PedroBMedeiros/PolySaber/PolySaber/PolySaber.kicad_pcb

## KiCad design PolySaber/PolySaber.kicad_pcb (2026-06-04)

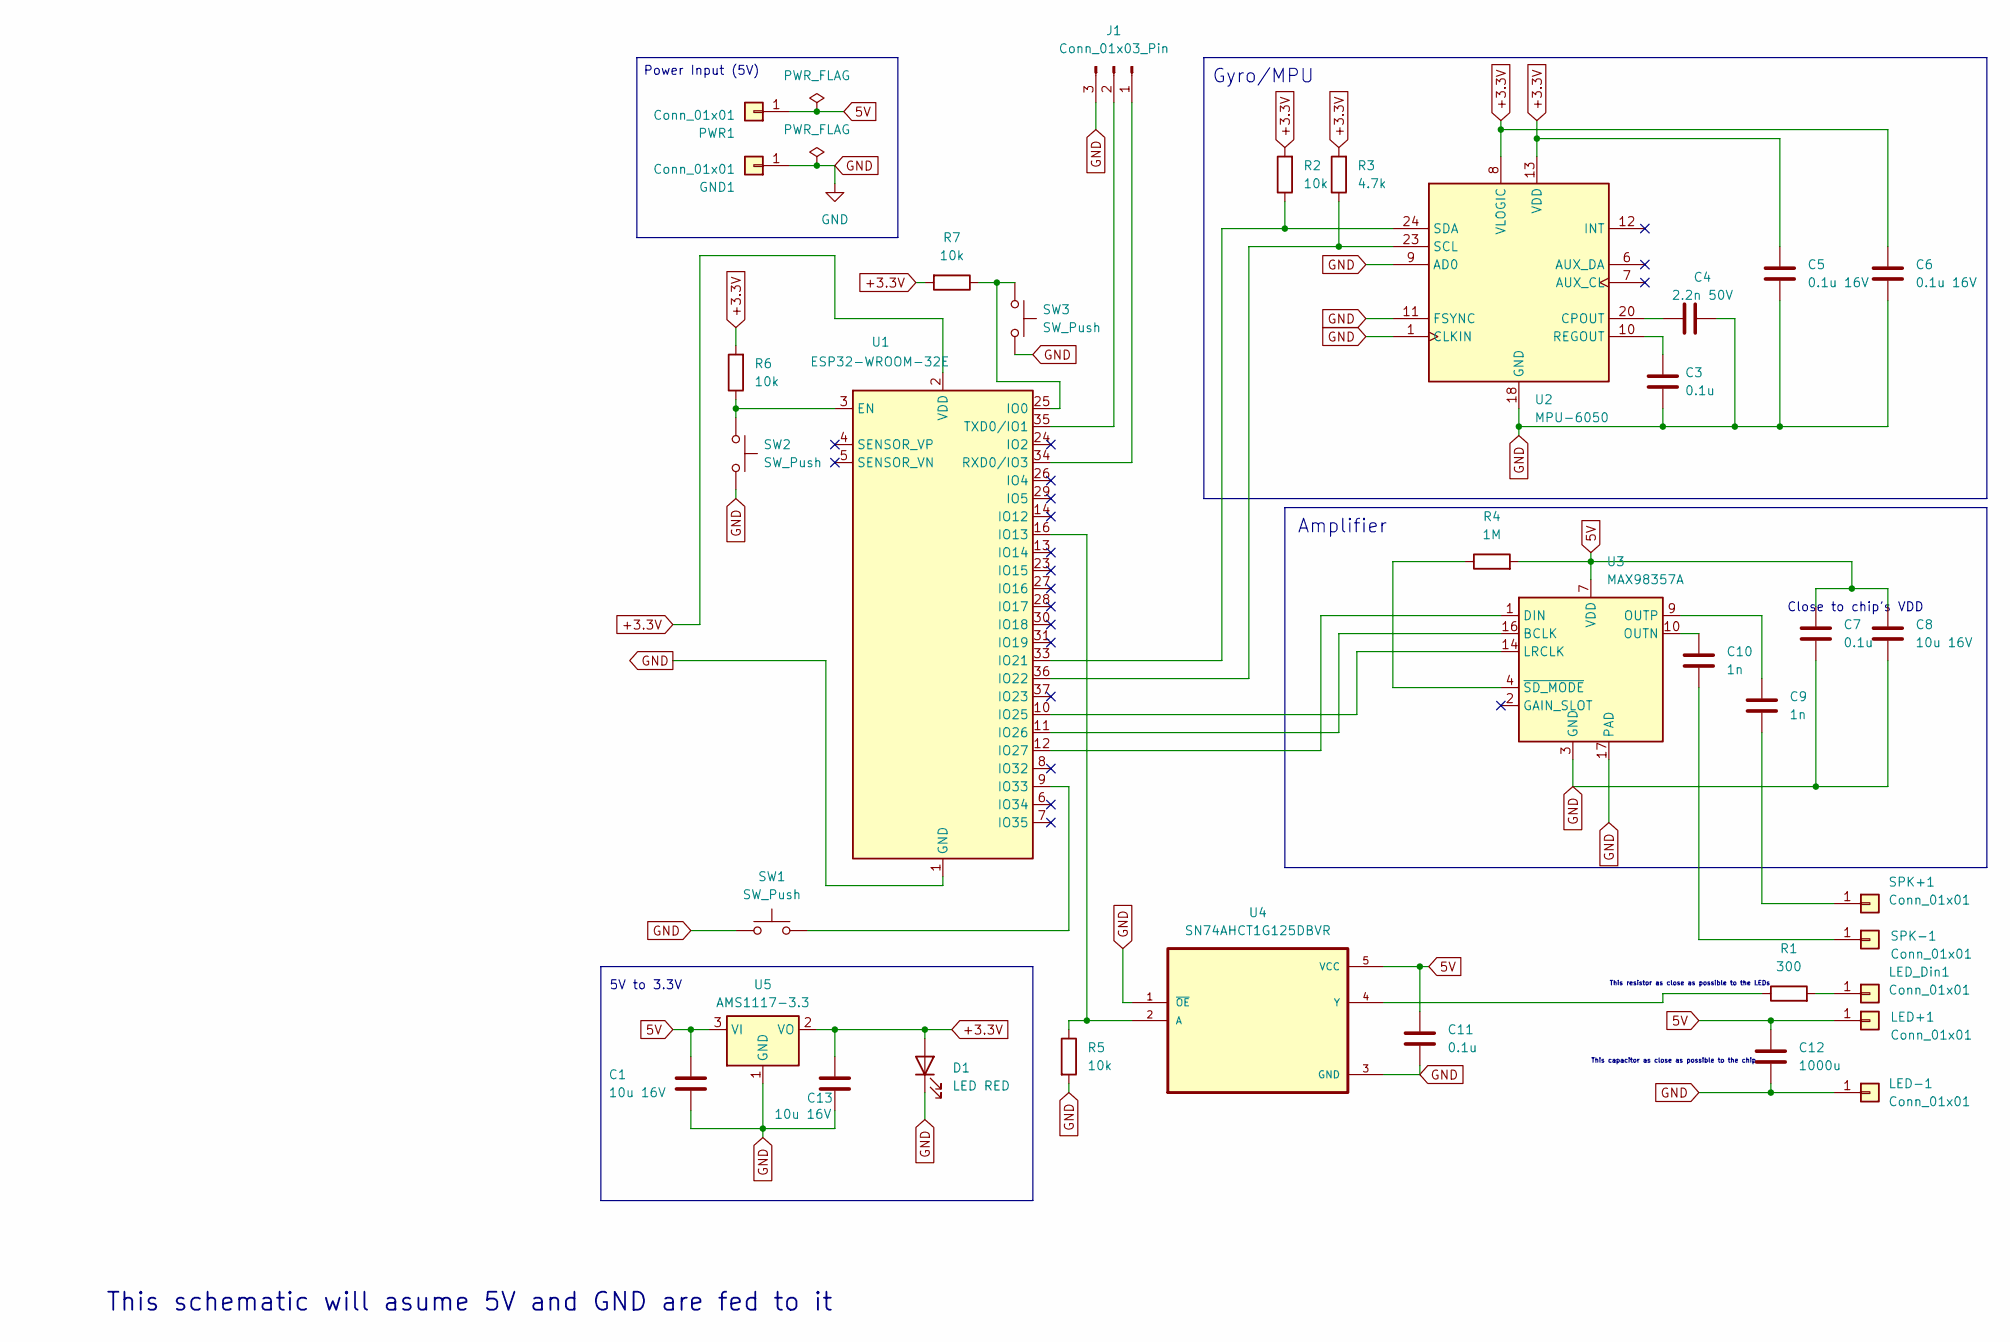
[picture p1: schematic PolySaber.kicad_sch]

Parts:
C1, C8, C13: 10u 16V; C_0603_1608Metric_Pad1.08x0.95mm_HandSolder; LCSC C19702
C3: 0.1u; C_0201_0603Metric_Pad0.64x0.40mm_HandSolder; LCSC C14663
C4: 2.2n 50V; C_0603_1608Metric_Pad1.08x0.95mm_HandSolder; LCSC C1604
C5, C6: 0.1u 16V; C_0603_1608Metric_Pad1.08x0.95mm_HandSolder; LCSC C14663
C7, C11: 0.1u; C_0603_1608Metric_Pad1.08x0.95mm_HandSolder; LCSC C14663
C9, C10: 1n; C_0201_0603Metric_Pad0.64x0.40mm_HandSolder; LCSC C1588
C12: 1000u; CP_Radial_D10.0mm_P5.00mm; LCSC C439782
D1: LED RED; LED_0603_1608Metric_Pad1.05x0.95mm_HandSolder; LCSC C2286
GND1: Conn_01x01; TestPoint_Pad_4.0x4.0mm
J1: Conn_01x03_Pin; PinHeader_1x03_P2.54mm_Vertical; LCSC C49257
LED+1: Conn_01x01; TestPoint_Pad_4.0x4.0mm
LED-1: Conn_01x01; TestPoint_Pad_4.0x4.0mm
LED_Din1: Conn_01x01; TestPoint_Pad_4.0x4.0mm
PWR1: Conn_01x01; TestPoint_Pad_4.0x4.0mm
R1: 300; R_0603_1608Metric_Pad0.98x0.95mm_HandSolder; LCSC C23025
R2, R5, R6, R7: 10k; R_0603_1608Metric_Pad0.98x0.95mm_HandSolder; LCSC C25804
R3: 4.7k; R_0603_1608Metric_Pad0.98x0.95mm_HandSolder; LCSC C23162
R4: 1M; R_0603_1608Metric_Pad0.98x0.95mm_HandSolder; LCSC C22935
SPK+1: Conn_01x01; TestPoint_Pad_4.0x4.0mm
SPK-1: Conn_01x01; TestPoint_Pad_4.0x4.0mm
SW1, SW2, SW3: SW_Push; SW_Tactile_SPST_NO_Straight_CK_PTS636Sx25SMTRLFS; LCSC C2689642
U1: ESP32-WROOM-32E; LCSC C701343
U2: MPU-6050; InvenSense_QFN-24_4x4mm_P0.5mm; LCSC C24112
U3: MAX98357A; TQFN-16-1EP_3x3mm_P0.5mm_EP1.23x1.23mm; LCSC C910544
U4: SN74AHCT1G125DBVR; SOT95P280X145-5N; LCSC C7484
U5: AMS1117-3.3; SOT-223-3_TabPin2; LCSC C6186

Connections:
5V: C1.1, C7.1, C8.1, C11.1, C12.1, LED+1.1, PWR1.1, R4.2, U3.7 (VDD), U3.8 (VDD), U4.5 (VCC), U5.3 (VI)
+3.3V: C5.1, C6.1, C13.1, D1.2 (A), R2.2, R3.2, R6.2, R7.2, U1.2 (VDD), U2.8 (VLOGIC), U2.13 (VDD), U5.2 (VO)
GND: C1.2, C3.2, C4.2, C5.2, C6.2, C7.2, C8.2, C11.2, C12.2, C13.2, D1.1 (K), GND1.1, J1.3, LED-1.1, R5.2, SW1.1, SW2.2, SW3.2, U1.1 (GND), U1.15 (GND), U1.38 (GND), U1.39 (GND), U2.1 (CLKIN), U2.9 (AD0), U2.11 (FSYNC), U2.18 (GND), U3.3 (GND), U3.11 (GND), U3.15 (GND), U3.17 (PAD), U4.1 (~OE), U4.3 (GND), U5.1 (GND)
unnamed: J1.1, U1.34 (RXD0/IO3)
unnamed: J1.2, U1.35 (TXD0/IO1)
unnamed: LED_Din1.1, R1.2
unnamed: C9.2, SPK+1.1
unnamed: C10.2, SPK-1.1
unnamed: R6.1, SW2.1, U1.3 (EN)
unnamed: R7.1, SW3.1, U1.25 (IO0)
unnamed: R5.1, U1.16 (IO13), U4.2 (A)
unnamed: R2.1, U1.33 (IO21), U2.24 (SDA)
unnamed: R3.1, U1.36 (IO22), U2.23 (SCL)
unnamed: U1.10 (IO25), U3.14 (LRCLK)
unnamed: U1.11 (IO26), U3.16 (BCLK)
unnamed: U1.12 (IO27), U3.1 (DIN)
unnamed: SW1.2, U1.9 (IO33)
unnamed: C4.1, U2.20 (CPOUT)
unnamed: C3.1, U2.10 (REGOUT)
unnamed: C10.1, U3.10 (OUTN)
unnamed: C9.1, U3.9 (OUTP)
unnamed: R4.1, U3.4 (~SD_MODE)
unnamed: R1.1, U4.4 (Y)

Notes on the sheet:
This schematic will asume 5V and GND are fed to it
Close to chip's VDD
This capacitor as close as possible to the chip
5V to 3.3V
This resistor as close as possible to the LEDs
Gyro/MPU
Amplifier
Power Input (5V)

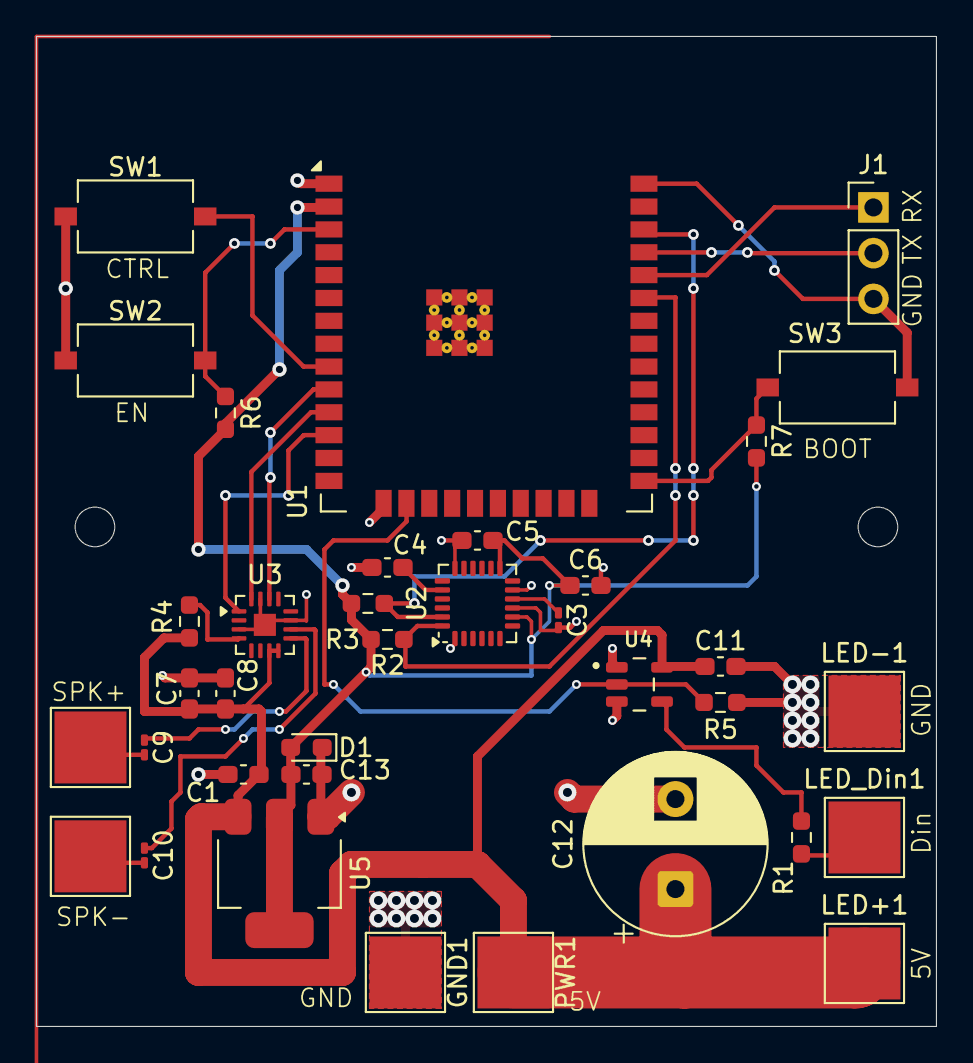
[picture p2: board PolySaber.kicad_pcb from above]

Board: 2 copper layers, 50.0 x 55.0 mm, 36 parts (0 on the bottom side), 23 nets.
