PedroBMedeiros/PolySaber/PolySaberFinalKicad/Zibs_Saber_v2.kicad_pcb

## KiCad design PolySaberFinalKicad/Zibs_Saber_v2.kicad_pcb (2026-06-04)

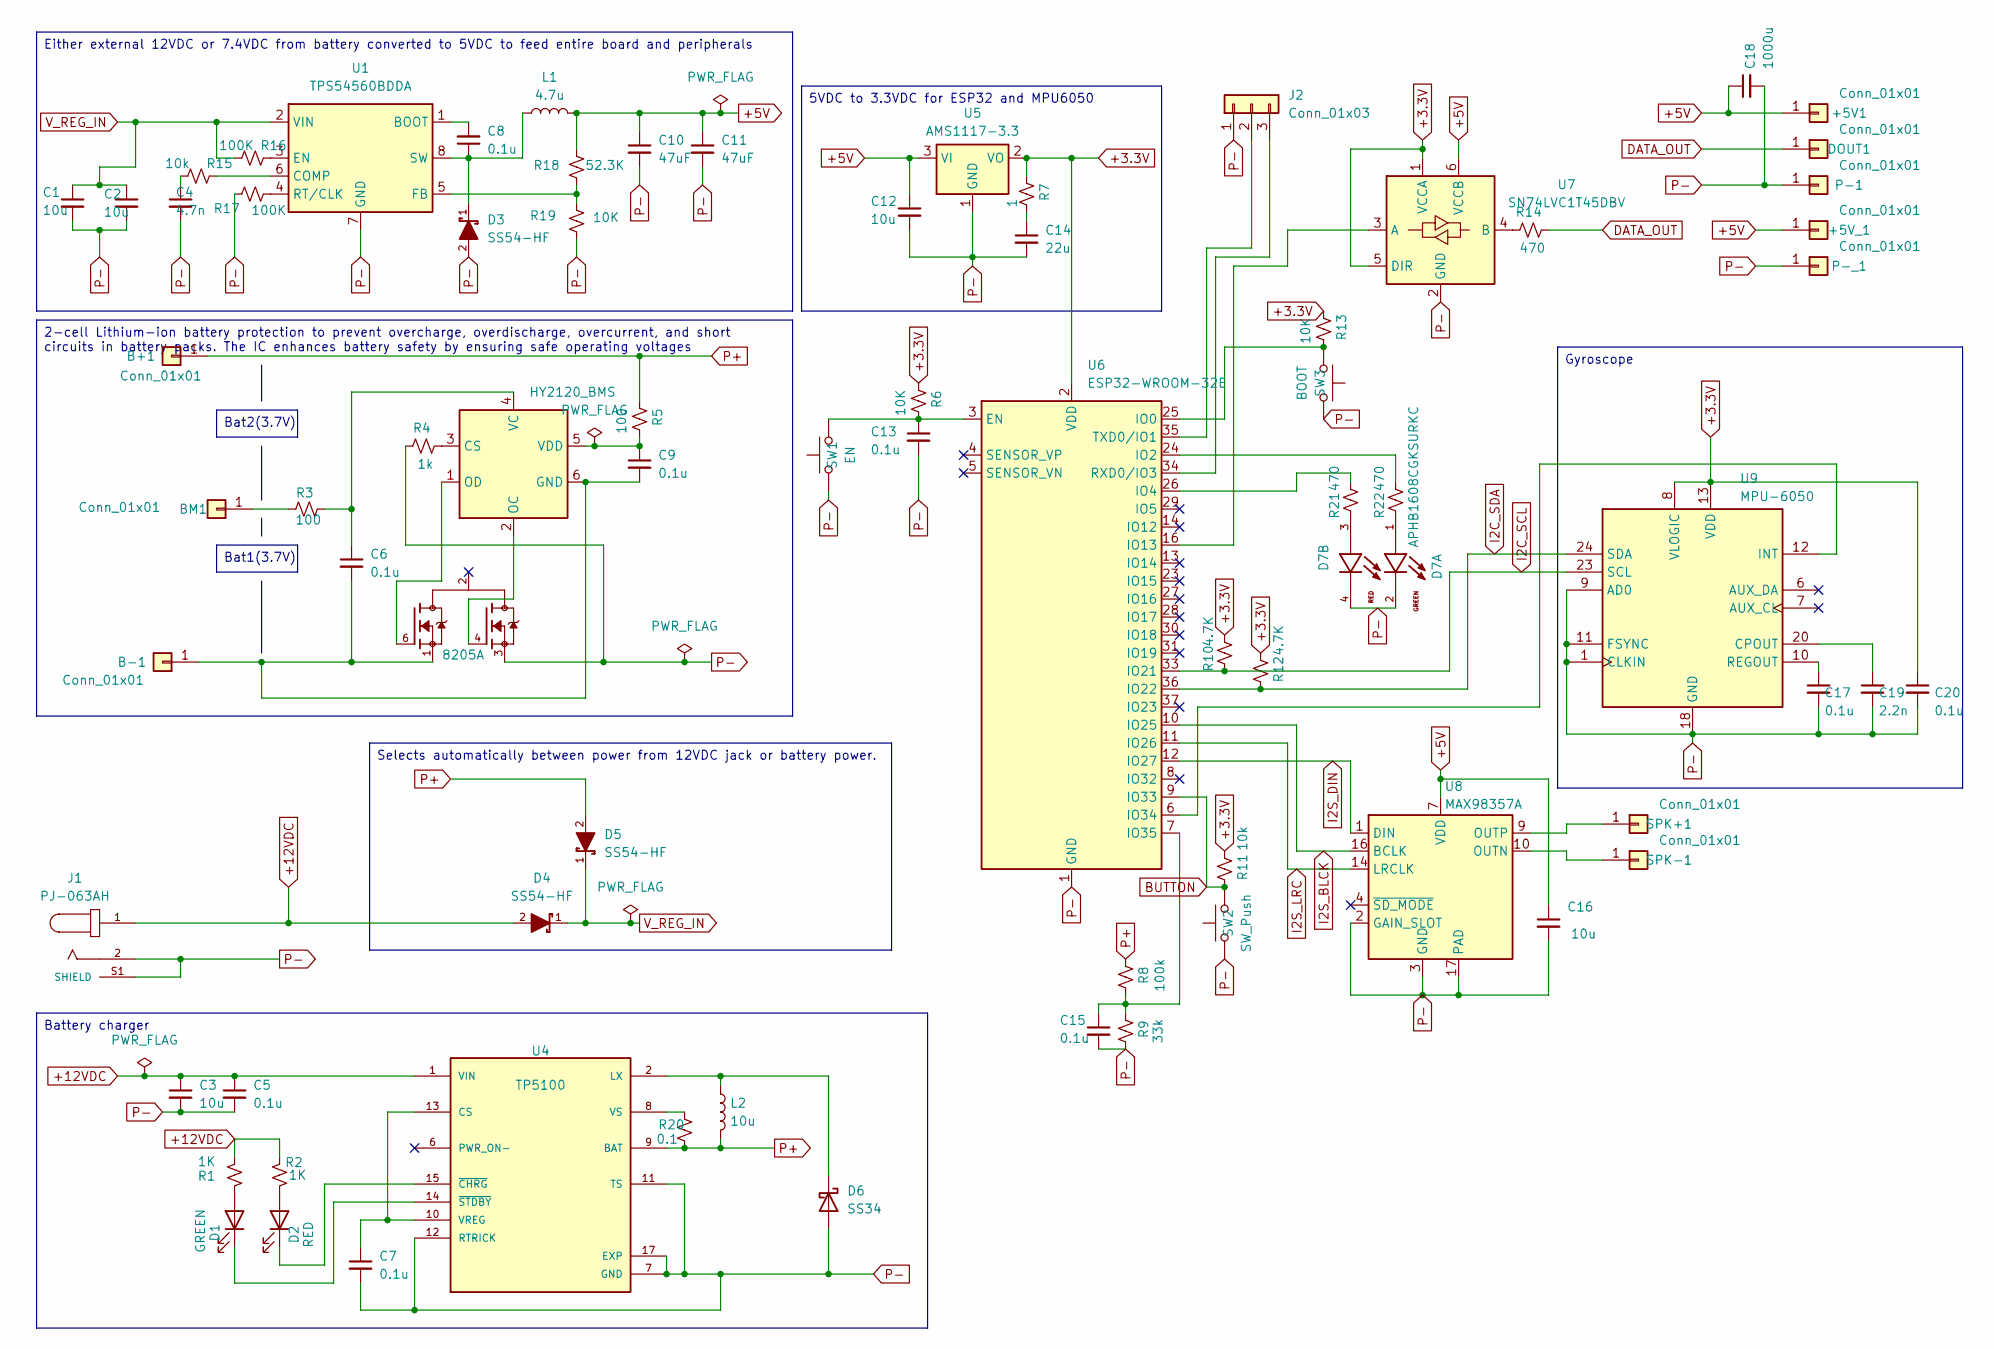
[picture p3: schematic Zibs_Saber_v2.kicad_sch]

Parts:
+5V1, +5V_1: Conn_01x01; TestPoint_Pad_4.0x4.0mm
B+1: Conn_01x01; TestPoint_Pad_4.0x4.0mm
B-1: Conn_01x01; TestPoint_Pad_4.0x4.0mm
BM1: Conn_01x01; TestPoint_Pad_4.0x4.0mm
C1, C2: 10u; C_1210_3225Metric; MANUFACTURER_PART_NUMBER CL32B106KBJNNNE; LCSC C18739
C3: 10u; C_1206_3216Metric; MANUFACTURER_PART_NUMBER CL31A106KAHNNNE; LCSC C9807
C4: 4.7n; C_0805_2012Metric_Pad1.18x1.45mm_HandSolder; MPN C50131; LCSC C50131
C5, C6, C7, C8, C9, C13, C15, C17, C20: 0.1u; C_0805_2012Metric_Pad1.18x1.45mm_HandSolder; MPN C126469; LCSC C126469
C10, C11: 47uF; C_1210_3225Metric; MPN C77101; LCSC C77101
C12, C16: 10u; C_0805_2012Metric_Pad1.18x1.45mm_HandSolder; MPN C15850; LCSC C15850
C14: 22u; C_0805_2012Metric_Pad1.18x1.45mm_HandSolder; MPN C45783; LCSC C45783
C18: 1000u; CP_Radial_D8.0mm_P3.50mm; MANUFACTURER_PART_NUMBER EEU-FR1J101B; LCSC C439782
C19: 2.2n; C_0805_2012Metric_Pad1.18x1.45mm_HandSolder; MPN C28260; LCSC C28260
D1: GREEN; LED_0805_2012Metric; MPN C2297; LCSC C2297
D2: RED; LED_0805_2012Metric; MPN C2295; LCSC C2295
D3, D4, D5: SS54-HF; SMCDO-214AB_CIP-M; MOUSER_PART_NUMBER 750-SS54-HF
D6: SS34; D_SMA; MPN C8678; LCSC C8678
D7: APHB1608CGKSURKC; LED_APHB1608CGKSURKC; PARTREV V.5A; LCSC C6506245
DOUT1: Conn_01x01; TestPoint_Pad_4.0x4.0mm
J1: PJ-063AH; CUI_PJ-063AH; PARTREV 1.02; LCSC C2928097
J2: Conn_01x03; PinHeader_1x03_P2.54mm_Horizontal; MPN C92159; LCSC C92159
L1: 4.7u; L_7.3x7.3_H4.5; MPN C136201; LCSC C136201
L2: 10u; L_7.3x7.3_H4.5; MPN C879412; LCSC C879412
P-1: Conn_01x01; TestPoint_Pad_4.0x4.0mm
P-_1: Conn_01x01; TestPoint_Pad_4.0x4.0mm
R1, R2: 1K; R_0805_2012Metric_Pad1.20x1.40mm_HandSolder; MPN C17513; LCSC C17513
R3, R5: 100; R_0805_2012Metric_Pad1.20x1.40mm_HandSolder; MPN C17408; LCSC C17408
R4: 1k; R_0805_2012Metric_Pad1.20x1.40mm_HandSolder; MPN C17513; LCSC C17513
R6, R13: 10K; R_0805_2012Metric_Pad1.20x1.40mm_HandSolder; MPN C17414; LCSC C17414
R7: 1; R_0805_2012Metric_Pad1.20x1.40mm_HandSolder; MPN C17376; LCSC C17376
R8: 100k; R_0805_2012Metric_Pad1.20x1.40mm_HandSolder; MPN C96346; LCSC C96346
R9: 33k; R_0805_2012Metric_Pad1.20x1.40mm_HandSolder; MPN C17633; LCSC C17633
R10, R12: 4.7K; R_0805_2012Metric_Pad1.20x1.40mm_HandSolder; MPN C17673; LCSC C17673
R11: 10k; R_0805_2012Metric_Pad1.20x1.40mm_HandSolder; MPN C17414; LCSC C17414
R14: 470; R_0805_2012Metric_Pad1.20x1.40mm_HandSolder; MPN C17710; LCSC C17710
R15: 10k; R_1206_3216Metric; MPN C17902; LCSC C17902
R16, R17: 100K; R_1206_3216Metric; MPN C17900; LCSC C17900
R18: 52.3K; R_1206_3216Metric; MPN C245568; LCSC C245568
R19: 10K; R_1206_3216Metric; MPN C17902; LCSC C17902
R20: 0.1; R_1206_3216Metric; MPN C346768; LCSC C346768
R21, R22: 470; R_0805_2012Metric_Pad1.20x1.40mm_HandSolder; MPN C206545; LCSC C206545
SPK+1: Conn_01x01; TestPoint_Pad_4.0x4.0mm
SPK-1: Conn_01x01; TestPoint_Pad_4.0x4.0mm
SW1: EN; SW_Tactile_SPST_NO_Straight_CK_PTS636Sx25SMTRLFS; MPN C2800443; LCSC C2800443
SW2: SW_Push; SW_PUSH_6mm; MPN C93157; LCSC C93157
SW3: BOOT; SW_Tactile_SPST_NO_Straight_CK_PTS636Sx25SMTRLFS; MPN C2800443; LCSC C2800443
U1: TPS54560BDDA; Texas_R-PDSO-G8_EP2.95x4.9mm_Mask2.4x3.1mm_ThermalVias; MPN C1850354; LCSC C1850354
U2: 8205A; SOT-23-6_Handsoldering; PARTREV NA; LCSC C181097
U3: HY2120_BMS; SOT-23-6; MPN C116509; LCSC C116509
U4: TP5100; QFN-16-1EP_4x4mm_P0.65mm_EP2.7x2.7mm; PARTREV 2.3; LCSC C379389
U5: AMS1117-3.3; SOT-223-3_TabPin2; MPN C347222; LCSC C347222
U6: ESP32-WROOM-32E; MPN C701342; LCSC C701342
U7: SN74LVC1T45DBV; SOT-23-6; MPN C7843; LCSC C7843
U8: MAX98357A; TQFN-16-1EP_3x3mm_P0.5mm_EP1.23x1.23mm; MPN C910544; LCSC C910544
U9: MPU-6050; InvenSense_QFN-24_4x4mm_P0.5mm; MPN C24112; LCSC C24112

Connections:
+3.3V: C20.1, R6.1, R7.1, R10.1, R11.1, R12.1, R13.1, U5.2 (VO), U6.2 (VDD), U7.1 (VCCA), U7.5 (DIR), U9.8 (VLOGIC), U9.13 (VDD)
+5V: +5V1.1, +5V_1.1, C10.1, C11.1, C12.1, C16.1, C18.1, L1.2, R18.1, U5.3 (VI), U7.6 (VCCB), U8.7 (VDD), U8.8 (VDD)
+12VDC: C3.1, C5.1, D4.2, J1.1, R1.1, R2.1, U4.1 (VIN), U4.4 (VIN), U4.5 (VIN), U4.16 (VIN)
BUTTON: R11.2, SW2.2, U6.9 (IO33)
DATA_OUT: DOUT1.1, R14.2
I2C_SCL: R10.2, U6.33 (IO21), U9.23 (SCL)
I2C_SDA: R12.2, U6.36 (IO22), U9.24 (SDA)
I2S_BLCK: U6.10 (IO25), U8.16 (BCLK)
I2S_DIN: U6.12 (IO27), U8.1 (DIN)
I2S_LRC: U6.11 (IO26), U8.14 (LRCLK)
unnamed: B-1.1, C6.2, C9.2, U2.1, U3.6 (GND)
unnamed: BM1.1, R3.1
unnamed: C4.1, R15.2
unnamed: C14.1, R7.2
unnamed: D1.2 (A), R1.2
unnamed: D1.1 (K), U4.14 (~STDBY)
unnamed: D2.2 (A), R2.2
unnamed: D2.1 (K), U4.15 (~CHRG)
unnamed: D6.1 (K), L2.1, U4.2 (LX), U4.3 (LX)
unnamed: D7.1, R22.2
unnamed: D7.3, R21.2
unnamed: J2.2, U6.35 (TXD0/IO1)
unnamed: J2.3, U6.34 (RXD0/IO3)
unnamed: SPK+1.1, U8.9 (OUTP)
unnamed: SPK-1.1, U8.10 (OUTN)
unnamed: C8.2, U1.1 (BOOT)
unnamed: R15.1, U1.6 (COMP)
unnamed: R16.1, U1.3 (EN)
unnamed: R18.2, R19.1, U1.5 (FB)
unnamed: R17.1, U1.4 (RT/CLK)
unnamed: C8.1, D3.1, L1.1, U1.8 (SW)
unnamed: R4.2, U3.3 (CS)
unnamed: U2.4, U3.2 (OC)
unnamed: U2.6, U3.1 (OD)
unnamed: C6.1, R3.2, U3.4 (VC)
unnamed: C9.1, R5.2, U3.5 (VDD)
unnamed: C7.1, U4.10 (VREG), U4.13 (CS)
unnamed: R20.1, U4.8 (VS)
unnamed: C13.1, R6.2, SW1.2, U6.3 (EN)
unnamed: R13.2, SW3.1, U6.25 (IO0)
unnamed: R22.1, U6.24 (IO2)
unnamed: R21.1, U6.26 (IO4)
unnamed: U6.16 (IO13), U7.3 (A)
unnamed: U6.6 (IO34), U9.12 (INT)
unnamed: C15.1, R8.2, R9.1, U6.7 (IO35)
unnamed: R14.1, U7.4 (B)
unnamed: C19.1, U9.20 (CPOUT)
unnamed: C17.1, U9.10 (REGOUT)
P+: B+1.1, D5.2, L2.2, R5.1, R8.1, R20.2, U4.9 (BAT)
P-: C1.2, C2.2, C3.2, C4.2, C5.2, C7.2, C10.2, C11.2, C12.2, C13.2, C14.2, C15.2, C16.2, C17.2, C18.2, C19.2, C20.2, D3.2, D6.2 (A), D7.2, D7.4, J1.2, J1.S1 (SHIELD), J1.S2 (SHIELD), J2.1, P-1.1, P-_1.1, R4.1, R9.2, R17.2, R19.2, SW1.1, SW2.1, SW3.2, U1.7 (GND), U1.9 (GND), U2.3, U4.7 (GND), U4.11 (TS), U4.12 (RTRICK), U4.17 (EXP), U5.1 (GND), U6.1 (GND), U6.15 (GND), U6.38 (GND), U6.39 (GND), U7.2 (GND), U8.2 (GAIN_SLOT), U8.3 (GND), U8.11 (GND), U8.15 (GND), U8.17 (PAD), U9.1 (CLKIN), U9.9 (AD0), U9.11 (FSYNC), U9.18 (GND)
V_REG_IN: C1.1, C2.1, D4.1, D5.1, R16.2, U1.2 (VIN)

Notes on the sheet:
2-cell Lithium-ion battery protection to prevent overcharge, overdischarge, overcurrent, and short circuits in battery packs. The IC enhances battery safety by ensuring safe operating voltages
Either external 12VDC or 7.4VDC from battery converted to 5VDC to feed entire board and peripherals
Bat1(3.7V)
Selects automatically between power from 12VDC jack or battery power.
Battery charger
Bat2(3.7V)
Gyroscope
5VDC to 3.3VDC for ESP32 and MPU6050

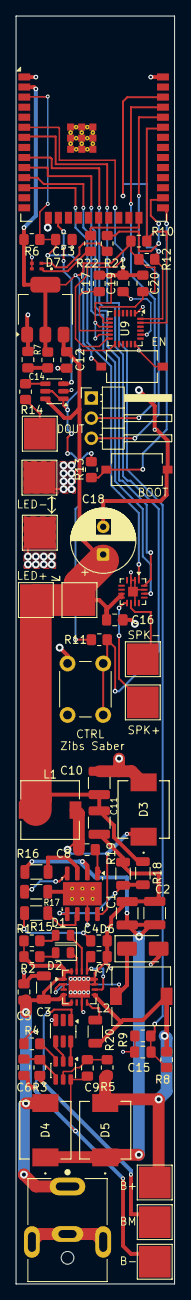
[picture p4: board Zibs_Saber_v2.kicad_pcb from above]

Board: 2 copper layers, 20.0 x 160.0 mm, 75 parts (0 on the bottom side), 51 nets.
