PedroBMedeiros/PolySaber/PolySaberFirmware/LEDs_button_no_gyro/OFF.h

const unsigned char PROGMEM OFF_wav[] = {
  0x52, 0x49, 0x46, 0x46, 0x6a, 0x8e, 0x00, 0x00, 0x57, 0x41, 0x56, 0x45,
  0x66, 0x6d, 0x74, 0x20, 0x10, 0x00, 0x00, 0x00, 0x01, 0x00, 0x01, 0x00,
  0x22, 0x56, 0x00, 0x00, 0x44, 0xac, 0x00, 0x00, 0x02, 0x00, 0x10, 0x00,
  0x64, 0x61, 0x74, 0x61, 0x46, 0x8e, 0x00, 0x00, 0x52, 0xef, 0xc0, 0xf1,
  0x46, 0xff, 0xbd, 0x05, 0x42, 0xff, 0xe7, 0xf0, 0x2b, 0xe7, 0x5a, 0xea,
  0x17, 0xee, 0x62, 0xe8, 0x01, 0xe2, 0x57, 0xe0, 0x72, 0xdd, 0x1d, 0xd5,
  0x96, 0xcb, 0xae, 0xca, 0x09, 0xd6, 0xbb, 0xe7, 0x15, 0xf9, 0x81, 0x04,
  0xfc, 0x07, 0xf0, 0x06, 0xfa, 0xfc, 0x6b, 0xe9, 0x6d, 0xe0, 0xf4, 0xed,
  0xa6, 0x02, 0x8a, 0x11, 0xa5, 0x19, 0x7b, 0x17, 0xf8, 0x09, 0x09, 0xf6,
  0xdd, 0xe2, 0xeb, 0xda, 0x81, 0xe2, 0x6f, 0xf1, 0xf6, 0xfe, 0xdd, 0x07,
  0xa3, 0x0b, 0x66, 0x0b, 0xd6, 0x06, 0xfa, 0xfb, 0x43, 0xec, 0x8b, 0xdd,
  0x21, 0xd6, 0x78, 0xd6, 0xad, 0xda, 0x23, 0xe2, 0x51, 0xeb, 0xfc, 0xf1,
  0xf7, 0xf8, 0x3b, 0x02, 0xde, 0x04, 0xd2, 0xfc, 0x21, 0xf3, 0xf4, 0xee,
  0x68, 0xee, 0x62, 0xea, 0xd9, 0xe1, 0xe0, 0xdd, 0xf5, 0xdf, 0xa8, 0xde,
  0x30, 0xdb, 0x7d, 0xde, 0x11, 0xe8, 0x51, 0xf2, 0x33, 0xf9, 0x47, 0xfc,
  0x16, 0xfd, 0x91, 0xf5, 0x80, 0xe1, 0xaa, 0xce, 0xff, 0xcb, 0x7d, 0xd7,
  0x9b, 0xe6, 0xd4, 0xf1, 0x23, 0xfb, 0xb6, 0x05, 0x44, 0x05, 0x81, 0xf1,
  0x13, 0xdd, 0x5c, 0xda, 0x36, 0xe6, 0xa1, 0xf5, 0x76, 0x00, 0x57, 0x07,
  0x8f, 0x10, 0x6e, 0x17, 0xb8, 0x11, 0x87, 0x02, 0x37, 0xf8, 0xd1, 0xff,
  0xb0, 0x12, 0x40, 0x17, 0xc5, 0x07, 0x62, 0xfa, 0x5a, 0xfa, 0x2d, 0x01,
  0xe0, 0x08, 0x1e, 0x0c, 0x16, 0x0c, 0x02, 0x0d, 0xd5, 0x04, 0x51, 0xee,
  0xc6, 0xda, 0x3f, 0xd6, 0xd2, 0xdb, 0x29, 0xe7, 0x3a, 0xf5, 0xe1, 0xff,
  0xb7, 0x04, 0x47, 0x05, 0xc6, 0x04, 0x25, 0x06, 0xdc, 0x08, 0x07, 0x0b,
  0xb2, 0x0a, 0x07, 0x05, 0xf4, 0xfb, 0x2d, 0xf6, 0x3d, 0xf7, 0x01, 0xff,
  0x2c, 0x0c, 0x86, 0x1a, 0x0d, 0x24, 0xd6, 0x24, 0x6a, 0x1e, 0xc4, 0x16,
  0x7e, 0x11, 0x51, 0x0d, 0xe2, 0x09, 0xfb, 0x09, 0xcd, 0x10, 0xee, 0x1d,
  0xee, 0x2b, 0xe6, 0x34, 0x6f, 0x38, 0x24, 0x38, 0xaf, 0x32, 0xa9, 0x26,
  0x20, 0x17, 0x9f, 0x0a, 0xdd, 0x06, 0xbd, 0x0b, 0x54, 0x13, 0x7c, 0x1b,
  0x30, 0x26, 0x32, 0x30, 0x51, 0x34, 0x44, 0x32, 0xfc, 0x26, 0x9d, 0x11,
  0x28, 0x01, 0x27, 0x01, 0xb0, 0x07, 0xb8, 0x09, 0x9f, 0x0a, 0xd7, 0x10,
  0xde, 0x1c, 0x85, 0x24, 0xb6, 0x1b, 0xa4, 0x09, 0xb8, 0xff, 0x8c, 0xfc,
  0x28, 0xf5, 0xd3, 0xed, 0x6e, 0xf2, 0xcb, 0x02, 0x3c, 0x13, 0xd2, 0x19,
  0x9f, 0x17, 0x11, 0x17, 0xf9, 0x1c, 0x56, 0x1c, 0x41, 0x09, 0x73, 0xf5,
  0x37, 0xfb, 0x9f, 0x10, 0x04, 0x18, 0xaa, 0x10, 0x9f, 0x11, 0x6c, 0x22,
  0x05, 0x35, 0xbd, 0x3a, 0x5e, 0x30, 0x34, 0x1d, 0xc6, 0x0c, 0x9e, 0x03,
  0x63, 0xfd, 0x97, 0xfb, 0x0c, 0x05, 0xb5, 0x14, 0x10, 0x1e, 0xba, 0x1e,
  0xf5, 0x18, 0x85, 0x0f, 0x38, 0x0a, 0xac, 0x0d, 0xfa, 0x12, 0x74, 0x13,
  0x13, 0x0f, 0x84, 0x08, 0x8d, 0x00, 0xba, 0xf9, 0x42, 0xfb, 0x55, 0x07,
  0xc2, 0x12, 0x8d, 0x14, 0xd5, 0x0e, 0x0f, 0x04, 0xe8, 0xf7, 0x1a, 0xf0,
  0x85, 0xea, 0x44, 0xe4, 0x6f, 0xe1, 0x14, 0xe2, 0xb1, 0xe4, 0xfd, 0xec,
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
};
unsigned int OFF_wav_len = 36466;
