PedroBMedeiros/PolySaber/PolySaberFirmware/LEDs_button_no_gyro/ON.h

const unsigned char PROGMEM ON_wav[] = {
  0x52, 0x49, 0x46, 0x46, 0xe0, 0xd9, 0x00, 0x00, 0x57, 0x41, 0x56, 0x45,
  0x66, 0x6d, 0x74, 0x20, 0x10, 0x00, 0x00, 0x00, 0x01, 0x00, 0x01, 0x00,
  0x22, 0x56, 0x00, 0x00, 0x44, 0xac, 0x00, 0x00, 0x02, 0x00, 0x10, 0x00,
  0x64, 0x61, 0x74, 0x61, 0x4a, 0xd9, 0x00, 0x00, 0x22, 0xff, 0xfa, 0xfe,
  0xdb, 0xfe, 0x3f, 0xff, 0xe4, 0xff, 0x88, 0xff, 0xcd, 0xfe, 0xf8, 0xfe,
  0x24, 0xff, 0xda, 0xfe, 0x23, 0xff, 0x10, 0x00, 0x36, 0x00, 0x61, 0xff,
  0x23, 0xff, 0xd1, 0xff, 0x26, 0x00, 0x01, 0x00, 0xeb, 0xff, 0x4e, 0xff,
  0xb8, 0xfe, 0x35, 0xff, 0x08, 0x00, 0x23, 0x00, 0x91, 0xff, 0xfa, 0xfe,
  0xe4, 0xfe, 0x1f, 0xff, 0xf0, 0xfe, 0xf9, 0xfe, 0x1d, 0xff, 0xd3, 0xfe,
  0x32, 0xff, 0x07, 0x00, 0x75, 0xff, 0xa6, 0xfe, 0x32, 0xff, 0xe2, 0xff,
  0x19, 0x00, 0xd7, 0xff, 0xef, 0xfe, 0xc4, 0xfe, 0xa9, 0xff, 0xf5, 0xff,
  0x02, 0x00, 0x35, 0x00, 0x77, 0xff, 0x16, 0xff, 0xdb, 0xff, 0xa2, 0xff,
  0xe5, 0xfe, 0xfe, 0xff, 0x17, 0x01, 0x83, 0x00, 0xe8, 0xff, 0x0d, 0x00,
  0x85, 0xff, 0x70, 0xfe, 0x0c, 0xfe, 0xc1, 0xfe, 0x44, 0xff, 0xd1, 0xfe,
  0xf4, 0xfe, 0x87, 0x00, 0x14, 0x01, 0x93, 0xff, 0xe9, 0xfe, 0x50, 0x00,
  0x12, 0x01, 0xdf, 0xff, 0xf2, 0xfe, 0x7f, 0xff, 0x27, 0x00, 0x02, 0x00,
  0x62, 0xff, 0x70, 0xfe, 0x08, 0xfe, 0x97, 0xff, 0xc2, 0x01, 0x69, 0x01,
  0xd6, 0xfe, 0x6a, 0xfe, 0xcb, 0x00, 0x29, 0x02, 0xff, 0x01, 0xb5, 0x02,
  0x93, 0x02, 0x48, 0xff, 0x48, 0xfc, 0x44, 0xfb, 0x6b, 0xf8, 0xf2, 0xf4,
  0x6e, 0xf6, 0x1a, 0xfb, 0x57, 0xfd, 0xee, 0xfd, 0x59, 0xfe, 0x2e, 0xfd,
  0xeb, 0xfb, 0xac, 0xfc, 0x31, 0xfe, 0x61, 0xff, 0xfa, 0xfe, 0x86, 0xfc,
  0xbc, 0xfc, 0x51, 0x01, 0xf5, 0x03, 0xbe, 0x03, 0x68, 0x04, 0x73, 0x02,
  0x91, 0xfd, 0xc0, 0xfe, 0x64, 0x05, 0x01, 0x07, 0xd6, 0x03, 0x90, 0x02,
  0x8d, 0x01, 0xf9, 0xff, 0x03, 0x03, 0xeb, 0x07, 0xa1, 0x06, 0x6b, 0x02,
  0x48, 0x02, 0x2a, 0x03, 0xe6, 0x02, 0xf6, 0x04, 0xac, 0x06, 0x30, 0x04,
  0xe1, 0x02, 0x42, 0x05, 0x3a, 0x05, 0xe7, 0x01, 0xb3, 0x00, 0xfe, 0x00,
  0xa0, 0xff, 0xae, 0xff, 0x24, 0x03, 0xe6, 0x03, 0x03, 0x00, 0x25, 0xfe,
  0x35, 0xfe, 0x32, 0xfb, 0x5f, 0xfa, 0x23, 0xfe, 0xb2, 0xfd, 0x09, 0xfd,
  0x74, 0x08, 0xa0, 0x13, 0x43, 0x0b, 0xee, 0xfb, 0x94, 0xfb, 0xc5, 0x02,
  0xac, 0xfd, 0xf0, 0xee, 0xf9, 0xe5, 0x0d, 0xe2, 0xe7, 0xd9, 0x59, 0xd9,
  0xc8, 0xef, 0x8a, 0x06, 0xc7, 0x01, 0xd7, 0xfa, 0x6b, 0x0d, 0xca, 0x14,
  0x49, 0xf9, 0x5b, 0xf0, 0xd6, 0x14, 0x6e, 0x30, 0x3a, 0x27, 0x5e, 0x11,
  0x2b, 0xef, 0x2e, 0xc6, 0xaf, 0xc7, 0x09, 0xfb, 0x87, 0x22, 0xfb, 0x18,
  0xe8, 0xf4, 0xa9, 0xda, 0x13, 0xda, 0x0b, 0xe6, 0x9e, 0xee, 0xa9, 0xf8,
  0x47, 0x03, 0x30, 0x00, 0x40, 0xf7, 0x8f, 0xf5, 0xf0, 0xec, 0x96, 0xdb,
  0x0f, 0xde, 0xf4, 0xf5, 0xef, 0x02, 0x36, 0xfe, 0x00, 0xfa, 0x01, 0xfa,
  0xa0, 0xfa, 0x98, 0x02, 0xc5, 0x13, 0x91, 0x21, 0x7e, 0x1b, 0x93, 0x05,
  0xf8, 0xfb, 0x31, 0x03, 0xa9, 0x00, 0x59, 0xf9, 0xb2, 0x03, 0x77, 0x0a,
  0xec, 0x01, 0xe3, 0x0f, 0x62, 0x33, 0x96, 0x37, 0x36, 0x16, 0x58, 0xf3,
  0xe2, 0xd4, 0x7e, 0xbf, 0x0c, 0xda, 0xf0, 0x23, 0xb0, 0x50, 0x4e, 0x30,
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
};
unsigned int ON_wav_len = 55784;
