PedroBMedeiros/PolySaber/(commit log)

2026-06-04 Kicad file Upload
    [NeoPixel_Saber_Core-all-pos.csv, Zibs_Saber_v2-B_Cu.gbl, Zibs_Saber_v2-B_Mask.gbs, Zibs_Saber_v2-B_Paste.gbp, Zibs_Saber_v2-B_Silkscreen.gbo, Zibs_Saber_v2-Edge_Cuts.gm1, Zibs_Saber_v2-F_Cu.gtl, Zibs_Saber_v2-F_Mask.gts]
2026-06-04 Final Revision Kicad Upload
    [NeoPixel_Saber_Core-all-pos.csv, Zibs_Saber_v2-B_Cu.gbl, Zibs_Saber_v2-B_Mask.gbs, Zibs_Saber_v2-B_Paste.gbp, Zibs_Saber_v2-B_Silkscreen.gbo, Zibs_Saber_v2-Edge_Cuts.gm1, Zibs_Saber_v2-F_Cu.gtl, Zibs_Saber_v2-F_Mask.gts]
2026-06-04 First PCB Revision
2026-06-04 First Revision of PCB
    [PolySaber-B_Cu.gbr, PolySaber-B_Fab.gbr, PolySaber-B_Mask.gbr, PolySaber-B_Silkscreen.gbr, PolySaber-Edge_Cuts.gbr, PolySaber-F_Cu.gbr, PolySaber-F_Fab.gbr, PolySaber-F_Mask.gbr]
